host-msdrumkit/host-msdrumkit.github.io/media/commercialdrumkit.jpg

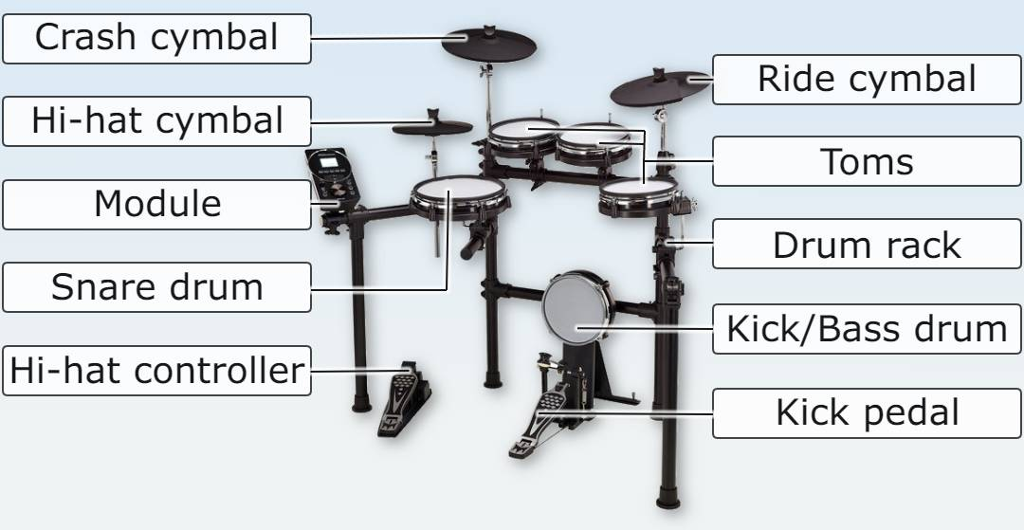
media/commercialdrumkit.jpg
