host-msdrumkit/host-msdrumkit.github.io/media/unaspad.png

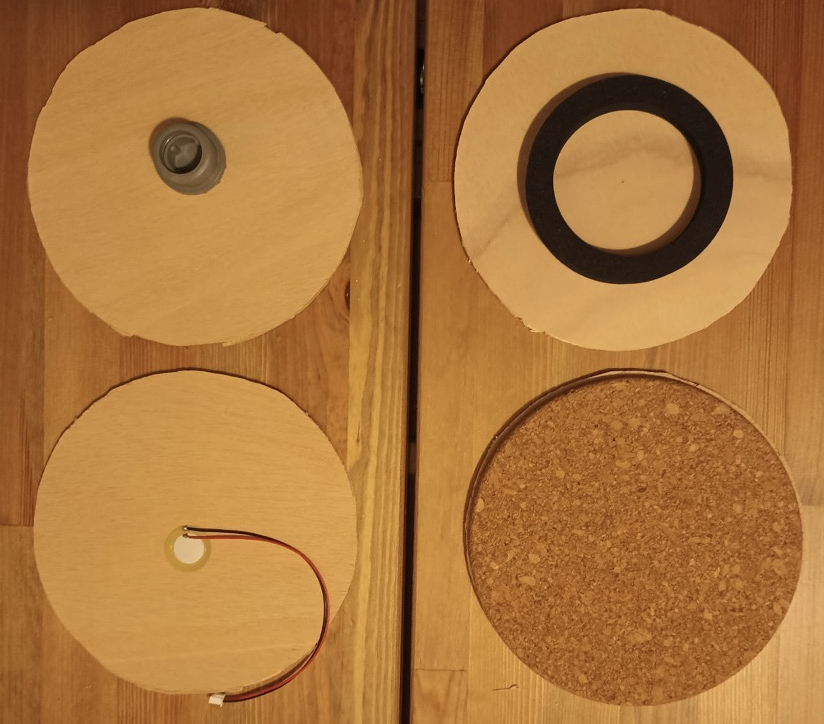
media/unaspad.png
