host-msdrumkit/host-msdrumkit.github.io/media/aspad.jpg

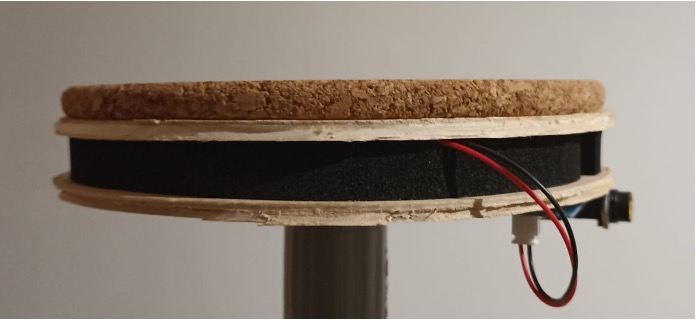
media/aspad.jpg
