host-msdrumkit/host-msdrumkit.github.io/media/background.png

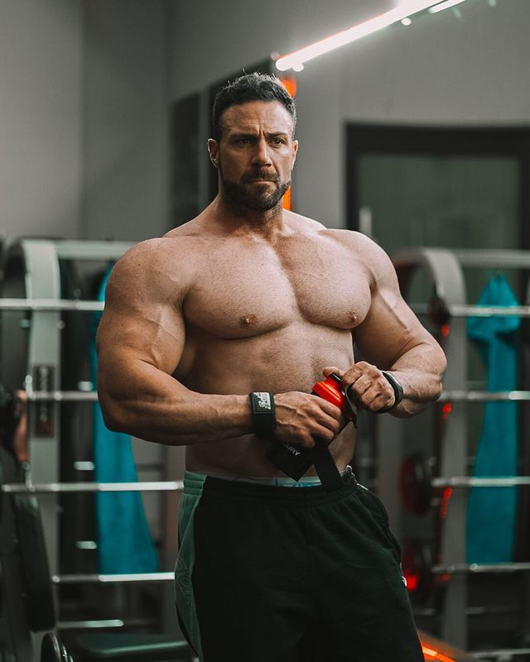
media/background.png
