host-msdrumkit/host-msdrumkit.github.io/media/drumkit.png

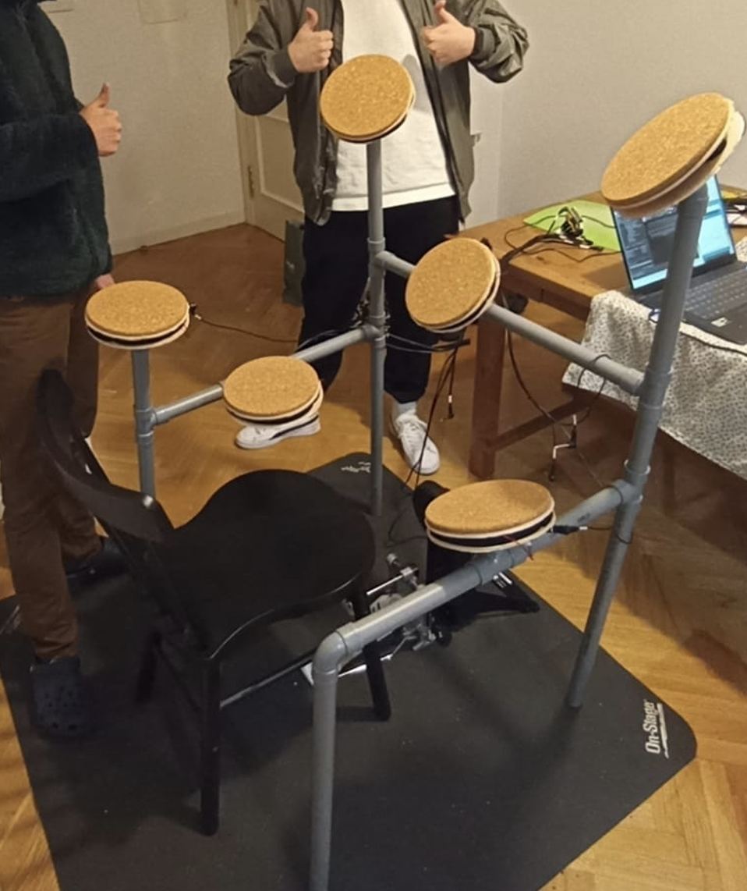
media/drumkit.png
