host-msdrumkit/host-msdrumkit.github.io/media/piezoelectric-effect.jpg

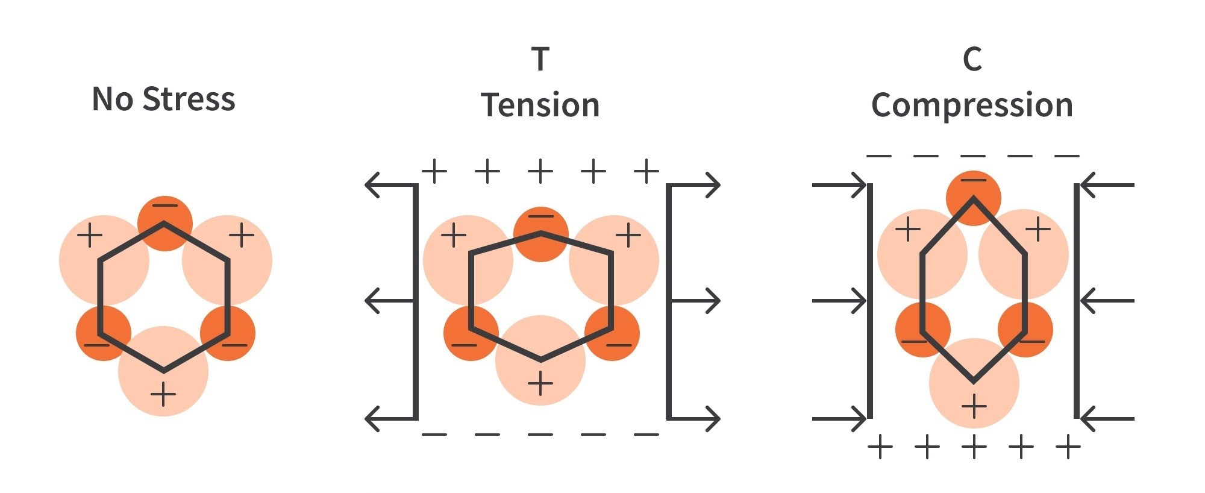
media/piezoelectric-effect.jpg
