host-msdrumkit/host-msdrumkit.github.io/media/pztstructure.png

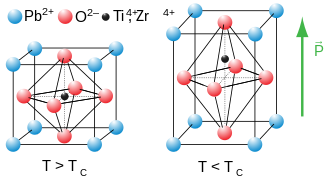
media/pztstructure.png
