host-msdrumkit/host-msdrumkit.github.io/media/try.png

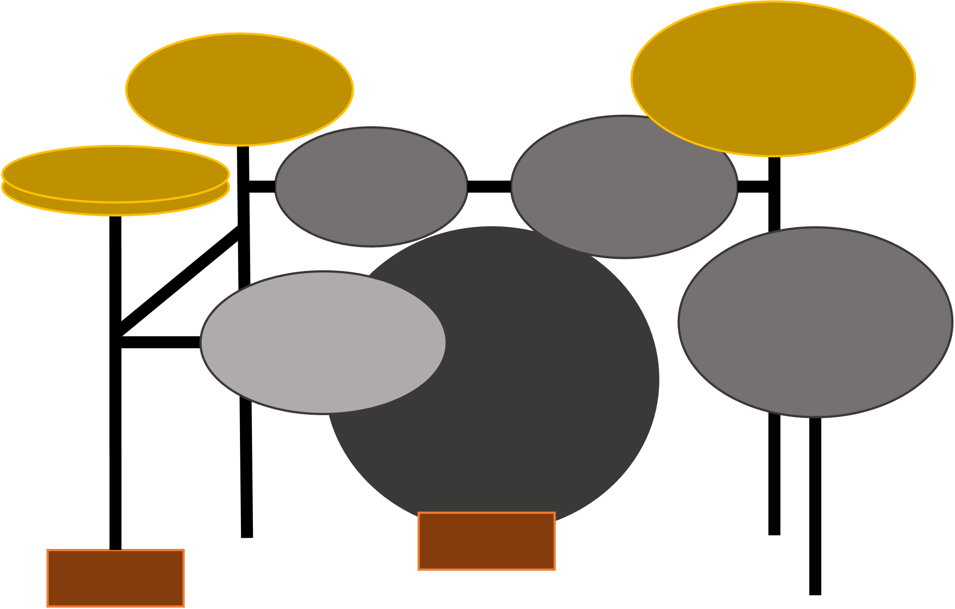
media/try.png
