host-msdrumkit/host-msdrumkit.github.io/(commit log)

2022-12-12 arduino code
2022-12-13 Upload assembled pad image map
